weili-pan/stm32f4xx_esp32s3_onenet_mqtt_modbus/lv_st7789_example/download.png

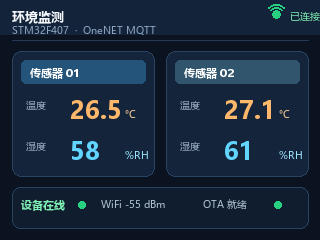
lv_st7789_example/download.png
