weili-pan/stm32f4xx_esp32s3_onenet_mqtt_modbus/(notices)

Notices in the files:
stm_part/stm_modbus/Core/Src/main.c:
Copyright (c) 2026 STMicroelectronics.
All rights reserved.
This software is licensed under terms that can be found in the LICENSE file
